Jeija/sigfox-chicken-coop/hardware_pdf/pcb.pdf

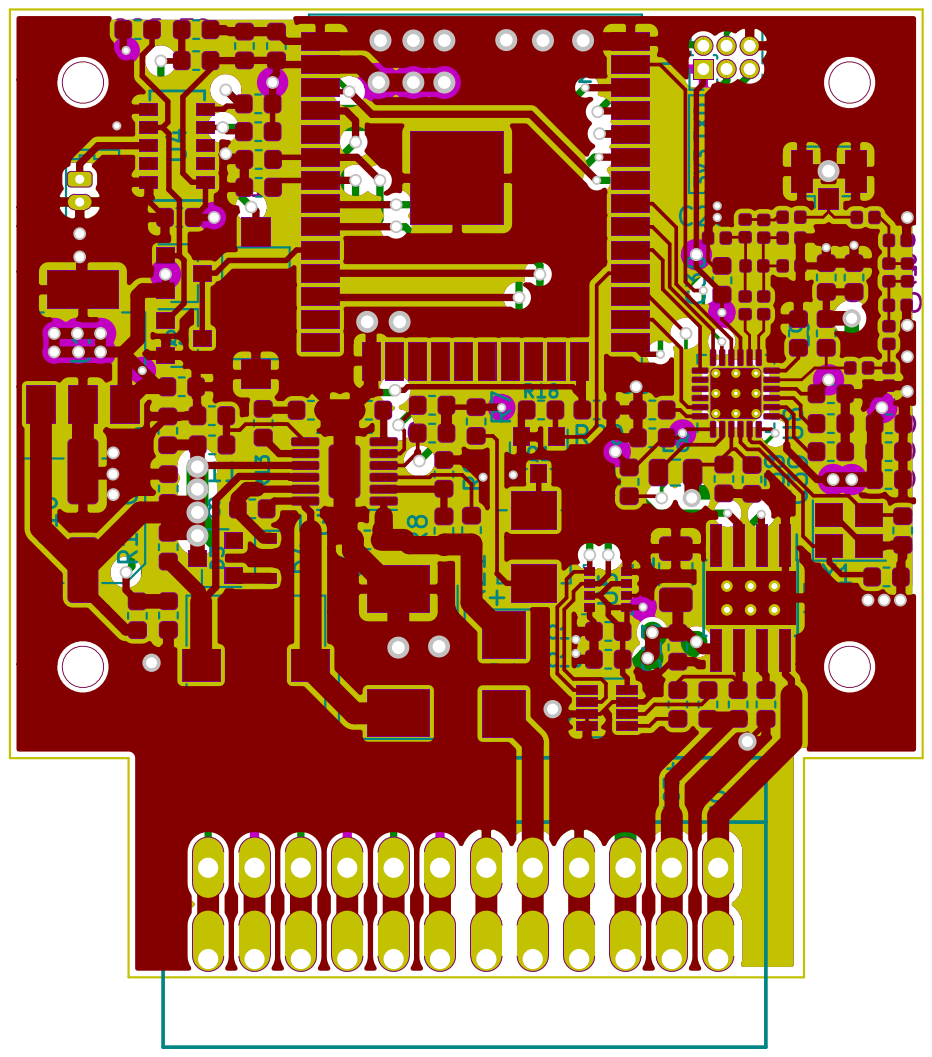
[picture p4: page 1]
