Jeija/sigfox-chicken-coop/hardware/huhnsfx.kicad_pcb

## KiCad design hardware/huhnsfx.kicad_pcb (2020-07-01)

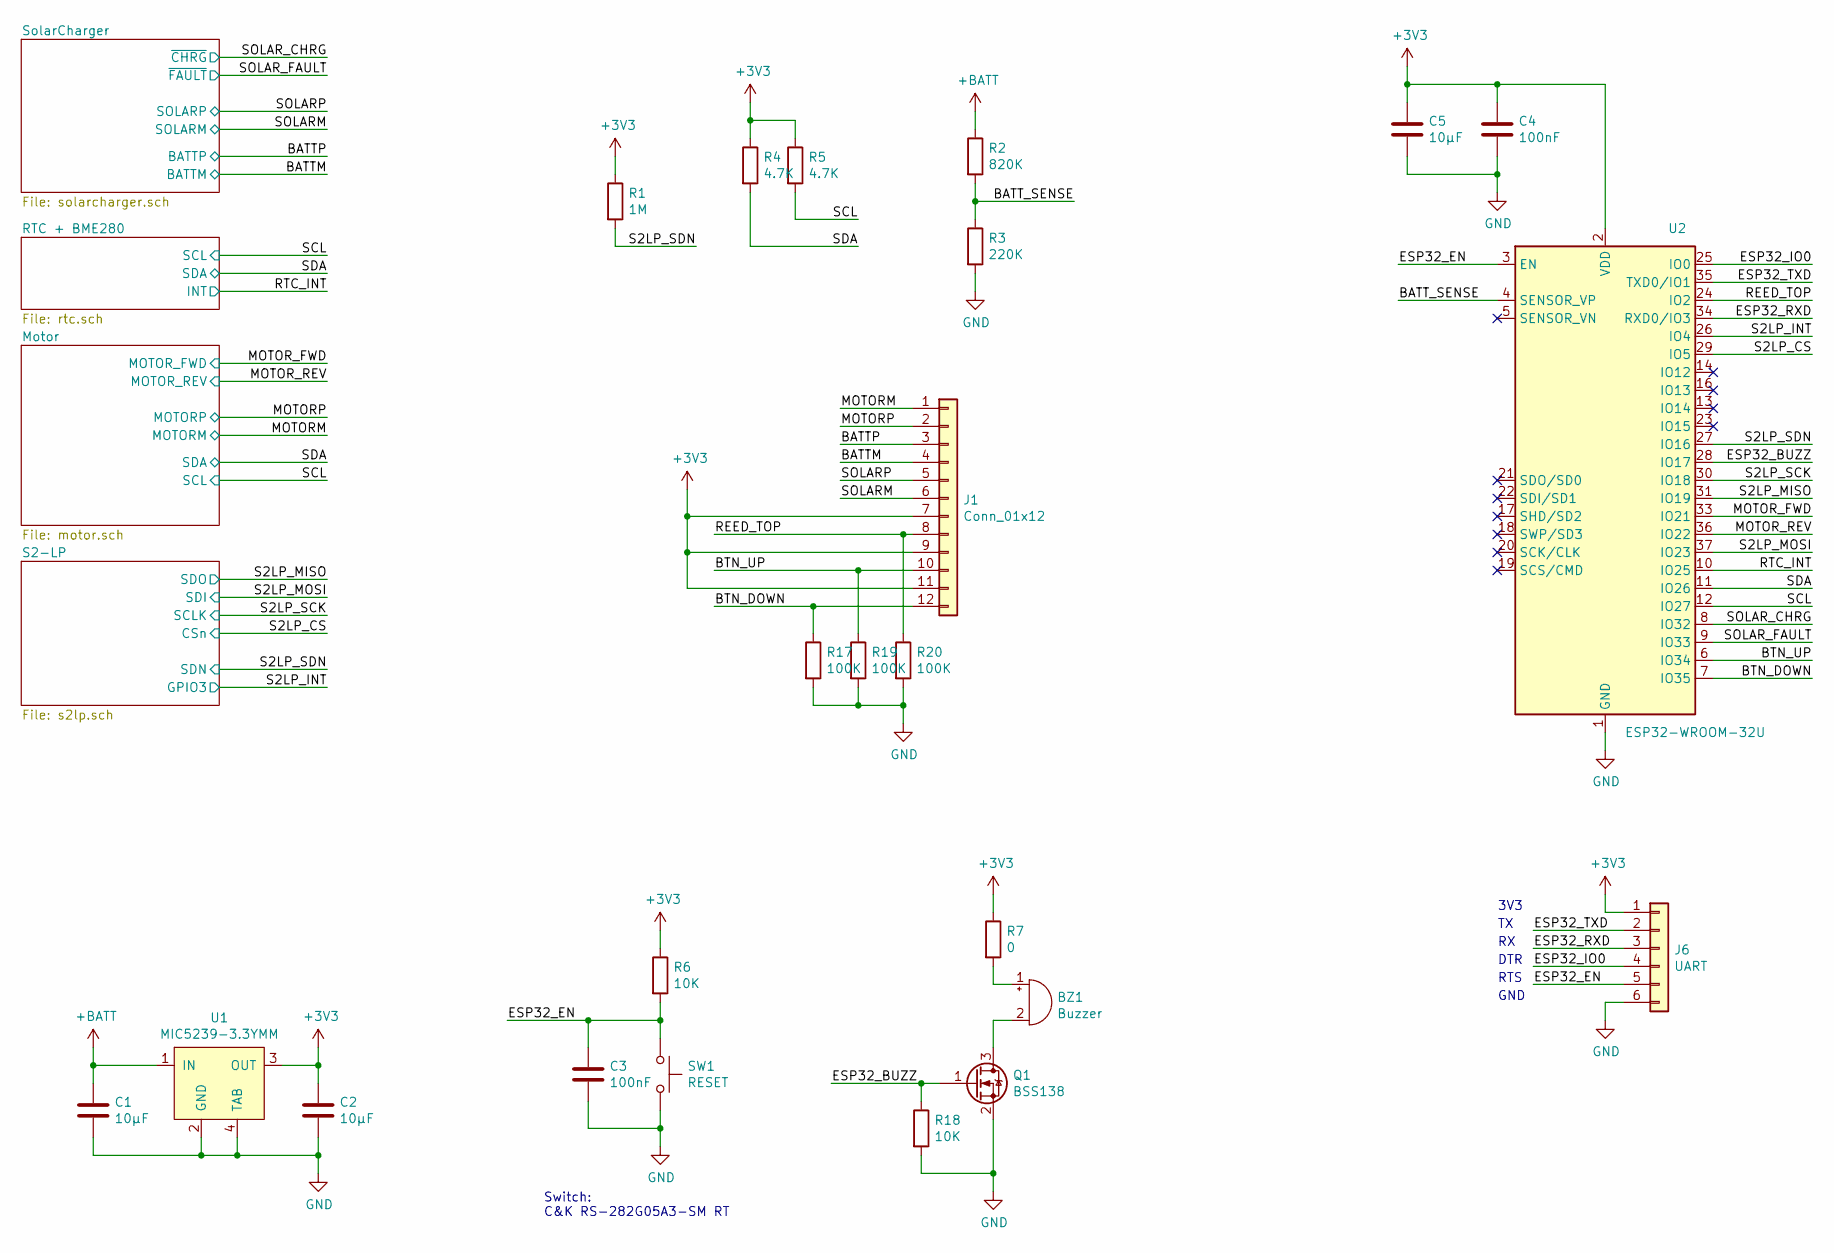
[picture p10: schematic huhnsfx.sch]

Parts:
BZ1: Buzzer; CMT-4023S
C1, C2, C5: 10µF; C_0603_1608Metric
C3, C4: 100nF; C_0603_1608Metric
J1: Conn_01x12; WAGO-233-512
J6: UART; PinHeader_2x03_P1.27mm_Vertical
Q1: BSS138; SOT-23
R1: 1M; R_0603_1608Metric
R2: 820K; R_0603_1608Metric
R3: 220K; R_0603_1608Metric
R4, R5: 4.7K; R_0603_1608Metric
R6, R18: 10K; R_0603_1608Metric
R7: 0; R_0603_1608Metric
R17, R19, R20: 100K; R_0603_1608Metric
SW1: RESET; SW_SPST_CK_RS282G05A3
U1: MIC5239-3.3YMM; SOT-223
U2: ESP32-WROOM-32U

Connections:
+3V3: C2.1, C4.1, C5.1, J1.7, J1.9, J1.11, J6.1, R1.1, R4.1, R5.1, R6.1, R7.1, U1.3 (OUT), U2.2 (VDD); also elsewhere on the board
+BATT: C1.1, J1.3, R2.1, U1.1 (IN); also elsewhere on the board
/BATT_SENSE: R2.2, R3.1, U2.4 (SENSOR_VP)
/BTN_DOWN: J1.12, R17.1, U2.7 (IO35)
/BTN_UP: J1.10, R19.1, U2.6 (IO34)
/ESP32_BUZZ: Q1.1 (G), R18.1, U2.28 (IO17)
/ESP32_EN: C3.1, J6.5, R6.2, SW1.1, U2.3 (EN)
/ESP32_IO0: J6.4, U2.25 (IO0)
/ESP32_RXD: J6.3, U2.34 (RXD0/IO3)
/ESP32_TXD: J6.2, U2.35 (TXD0/IO1)
/MOTORM: J1.1; also elsewhere on the board
/MOTORP: J1.2; also elsewhere on the board
/MOTOR_FWD: U2.33 (IO21); also elsewhere on the board
/MOTOR_REV: U2.36 (IO22); also elsewhere on the board
/REED_TOP: J1.8, R20.1, U2.24 (IO2)
/RTC_INT: U2.10 (IO25); also elsewhere on the board
/S2LP_CS: U2.29 (IO5); also elsewhere on the board
/S2LP_INT: U2.26 (IO4); also elsewhere on the board
/S2LP_MISO: U2.31 (IO19); also elsewhere on the board
/S2LP_MOSI: U2.37 (IO23); also elsewhere on the board
/S2LP_SCK: U2.30 (IO18); also elsewhere on the board
/S2LP_SDN: R1.2, U2.27 (IO16); also elsewhere on the board
/SCL: R5.2, U2.12 (IO27); also elsewhere on the board
/SDA: R4.2, U2.11 (IO26); also elsewhere on the board
/SOLARP: J1.5; also elsewhere on the board
/SOLAR_CHRG: U2.8 (IO32); also elsewhere on the board
/SOLAR_FAULT: U2.9 (IO33); also elsewhere on the board
GND: C1.2, C2.2, C3.2, C4.2, C5.2, J1.4, J1.6, J6.6, Q1.2 (S), R3.2, R17.2, R18.2, R19.2, R20.2, SW1.2, U1.2 (GND), U1.4 (TAB), U2.1 (GND), U2.15 (GND), U2.38 (GND), U2.39 (GND); also elsewhere on the board
unnamed: BZ1.1 (-), R7.2
unnamed: BZ1.2 (+), Q1.3 (D)

Notes on the sheet:
DTR
RTS
GND
3V3
Switch: C&K RS-282G05A3-SM RT

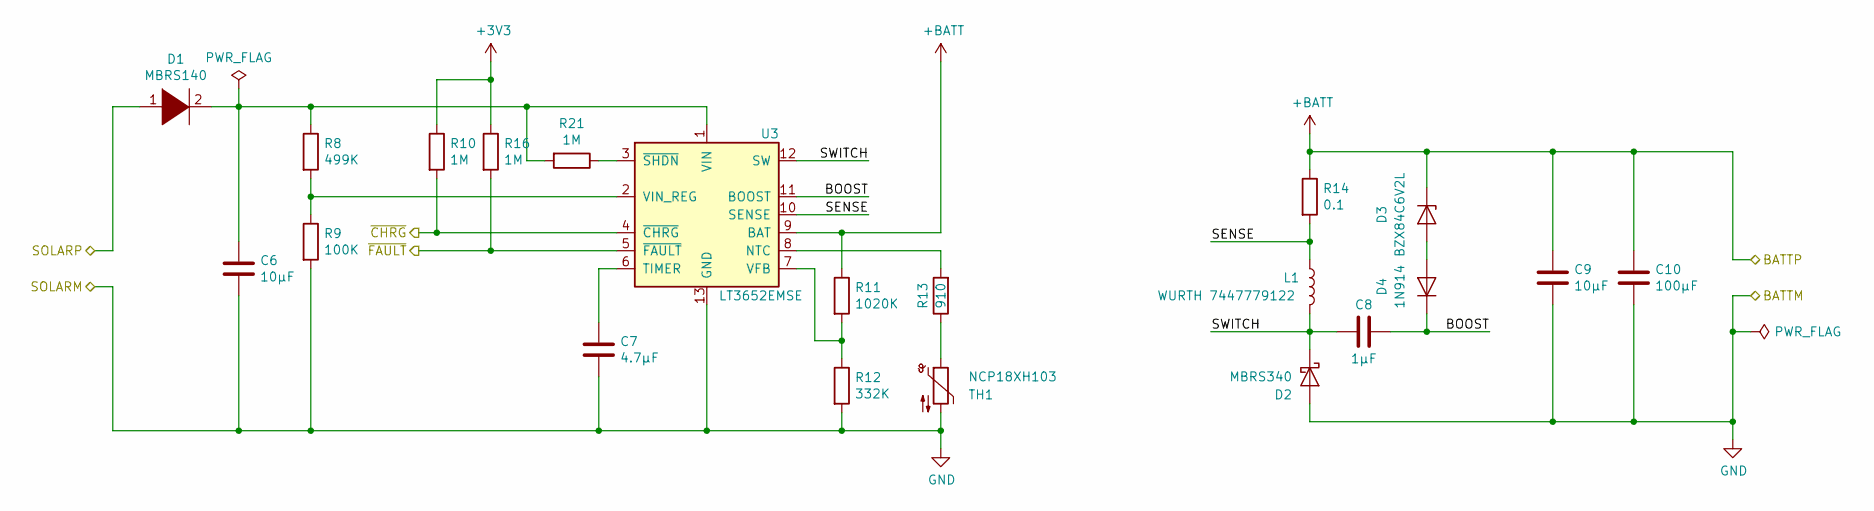
[picture p11: schematic solarcharger.sch]

Parts:
C6, C9: 10µF; C_0603_1608Metric
C7: 4.7µF; C_0603_1608Metric
C8: 1µF; C_0603_1608Metric
C10: 100µF; CP_Elec_6.3x3
D1: MBRS140; D_SMB
D2: MBRS340; D_SMC
D3: BZX84C6V2L; D_SOT-23_ANK
D4: 1N914; D_SOD-323F
L1: WURTH 7447779122; L_Wuerth_WE-PD-Typ-7345
R8: 499K; R_0603_1608Metric
R9: 100K; R_0603_1608Metric
R10, R16, R21: 1M; R_0603_1608Metric
R11: 1020K; R_0603_1608Metric
R12: 332K; R_0603_1608Metric
R13: 910; R_0603_1608Metric
R14: 0.1; R_0603_1608Metric
TH1: NCP18XH103; R_0603_1608Metric
U3: LT3652EMSE; MSOP-12-1EP_3x4mm_P0.65mm_EP1.65x2.85mm

Connections:
+3V3: R10.1, R16.1; also elsewhere on the board
+BATT: C9.1, C10.1, D3.1 (K), R11.1, R14.1, U3.9 (BAT); also elsewhere on the board
/SOLARP: D1.1 (K); also elsewhere on the board
/SOLAR_CHRG: R10.2, U3.4 (~CHRG); also elsewhere on the board
/SOLAR_FAULT: R16.2, U3.5 (~FAULT); also elsewhere on the board
/SolarCharger/BOOST: C8.1, D4.1 (K), U3.11 (BOOST)
/SolarCharger/SENSE: L1.1, R14.2, U3.10 (SENSE)
/SolarCharger/SWITCH: C8.2, D2.1 (K), L1.2, U3.12 (SW)
GND: C6.2, C7.2, C9.2, C10.2, D2.2 (A), R9.2, R12.2, TH1.2, U3.13 (GND); also elsewhere on the board
unnamed: C6.1, D1.2 (A), R8.1, R21.2, U3.1 (VIN)
unnamed: C7.1, U3.6 (TIMER)
unnamed: D3.2 (A), D4.2 (A)
unnamed: R8.2, R9.1, U3.2 (VIN_REG)
unnamed: R11.2, R12.1, U3.7 (VFB)
unnamed: R13.1, TH1.1
unnamed: R13.2, U3.8 (NTC)
unnamed: R21.1, U3.3 (~SHDN)

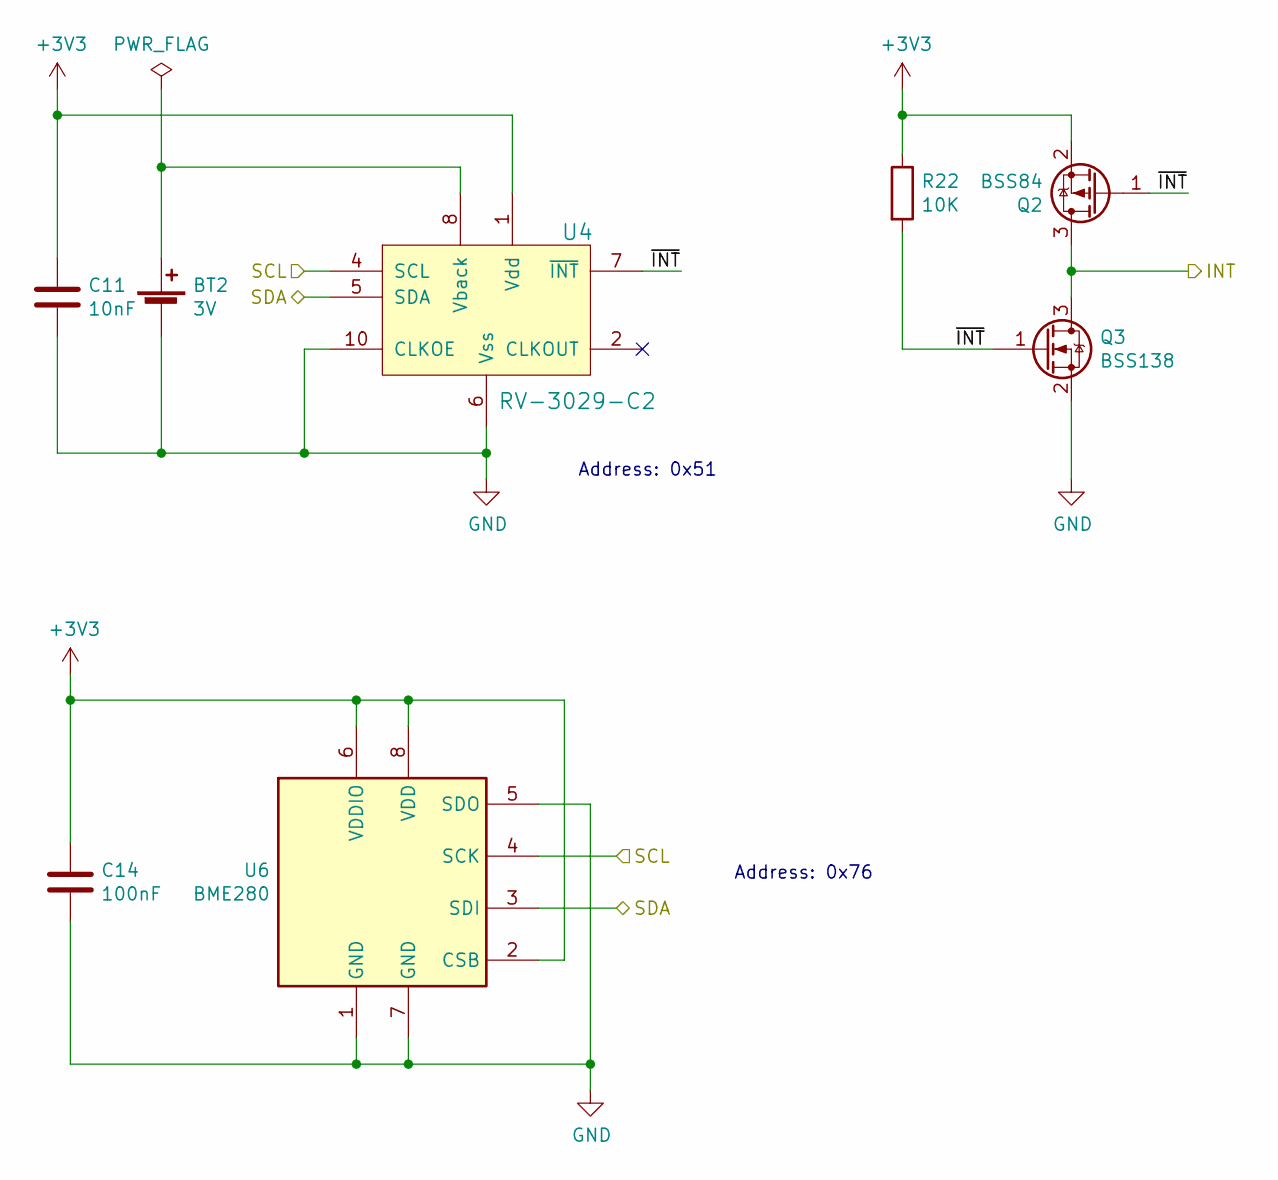
[picture p12: schematic rtc.sch]

Parts:
BT2: 3V; Molex_PicoBlade_53047-0210_1x02_P1.25mm_Vertical
C11: 10nF; C_0603_1608Metric
C14: 100nF; C_0603_1608Metric
Q2: BSS84; SOT-23
Q3: BSS138; SOT-23
R22: 10K; R_0603_1608Metric
U4: RV-3029-C2; rv3029
U6: BME280; Bosch_LGA-8_2.5x2.5mm_P0.65mm_ClockwisePinNumbering

Connections:
+3V3: C11.1, C14.1, Q2.2 (S), R22.1, U4.1 (Vdd), U6.2 (CSB), U6.6 (VDDIO), U6.8 (VDD); also elsewhere on the board
/RTC + BME280/~INT: Q2.1 (G), Q3.1 (G), R22.2, U4.7 (~INT)
/RTC_INT: Q2.3 (D), Q3.3 (D); also elsewhere on the board
/SCL: U4.4 (SCL), U6.4 (SCK); also elsewhere on the board
/SDA: U4.5 (SDA), U6.3 (SDI); also elsewhere on the board
GND: BT2.2 (-), C11.2, C14.2, Q3.2 (S), U4.6 (Vss), U4.10 (CLKOE), U6.1 (GND), U6.5 (SDO), U6.7 (GND); also elsewhere on the board
unnamed: BT2.1 (+), U4.8 (Vback)

Notes on the sheet:
Address: 0x76
Address: 0x51

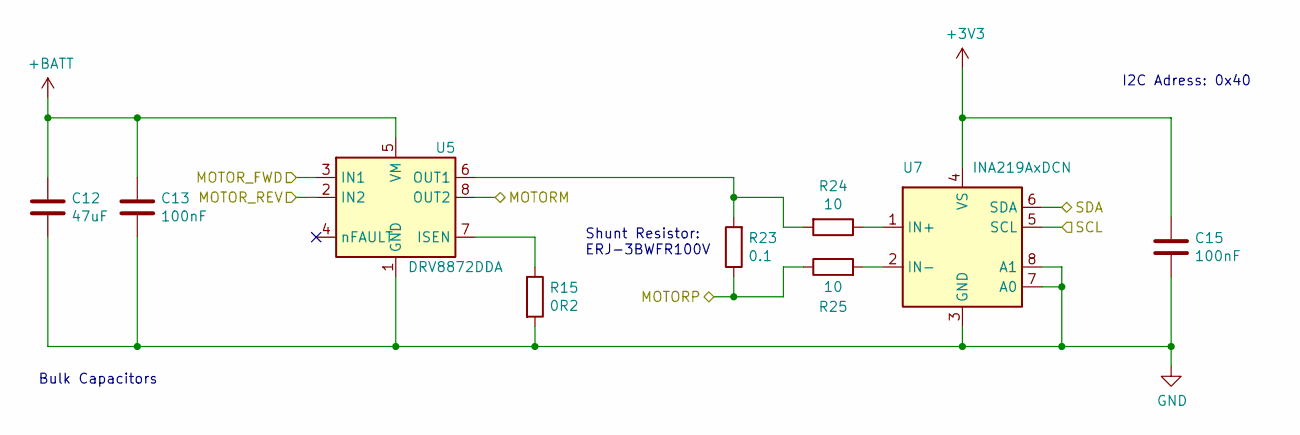
[picture p13: schematic motor.sch]

Parts:
C12: 47uF; C_1206_3216Metric
C13, C15: 100nF; C_0603_1608Metric
R15: 0R2; R_0603_1608Metric
R23: 0.1; R_0603_1608Metric
R24, R25: 10; R_0603_1608Metric
U5: DRV8872DDA; Texas_HTSOP-8-1EP_3.9x4.9mm_P1.27mm_EP2.95x4.9mm_Mask2.4x3.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
U7: INA219AxDCN; SOT-23-8

Connections:
+3V3: C15.1, U7.4 (VS); also elsewhere on the board
+BATT: C12.1, C13.1, U5.5 (VM); also elsewhere on the board
/MOTORM: U5.8 (OUT2); also elsewhere on the board
/MOTORP: R23.1, R25.1; also elsewhere on the board
/MOTOR_FWD: U5.3 (IN1); also elsewhere on the board
/MOTOR_REV: U5.2 (IN2); also elsewhere on the board
/SCL: U7.5 (SCL); also elsewhere on the board
/SDA: U7.6 (SDA); also elsewhere on the board
GND: C12.2, C13.2, C15.2, R15.2, U5.1 (GND), U5.9 (GND), U7.3 (GND), U7.7 (A0), U7.8 (A1); also elsewhere on the board
unnamed: R15.1, U5.7 (ISEN)
unnamed: R23.2, R24.2, U5.6 (OUT1)
unnamed: R24.1, U7.1 (IN+)
unnamed: R25.2, U7.2 (IN-)

Notes on the sheet:
Bulk Capacitors
I2C Adress: 0x40
Shunt Resistor: ERJ-3BWFR100V

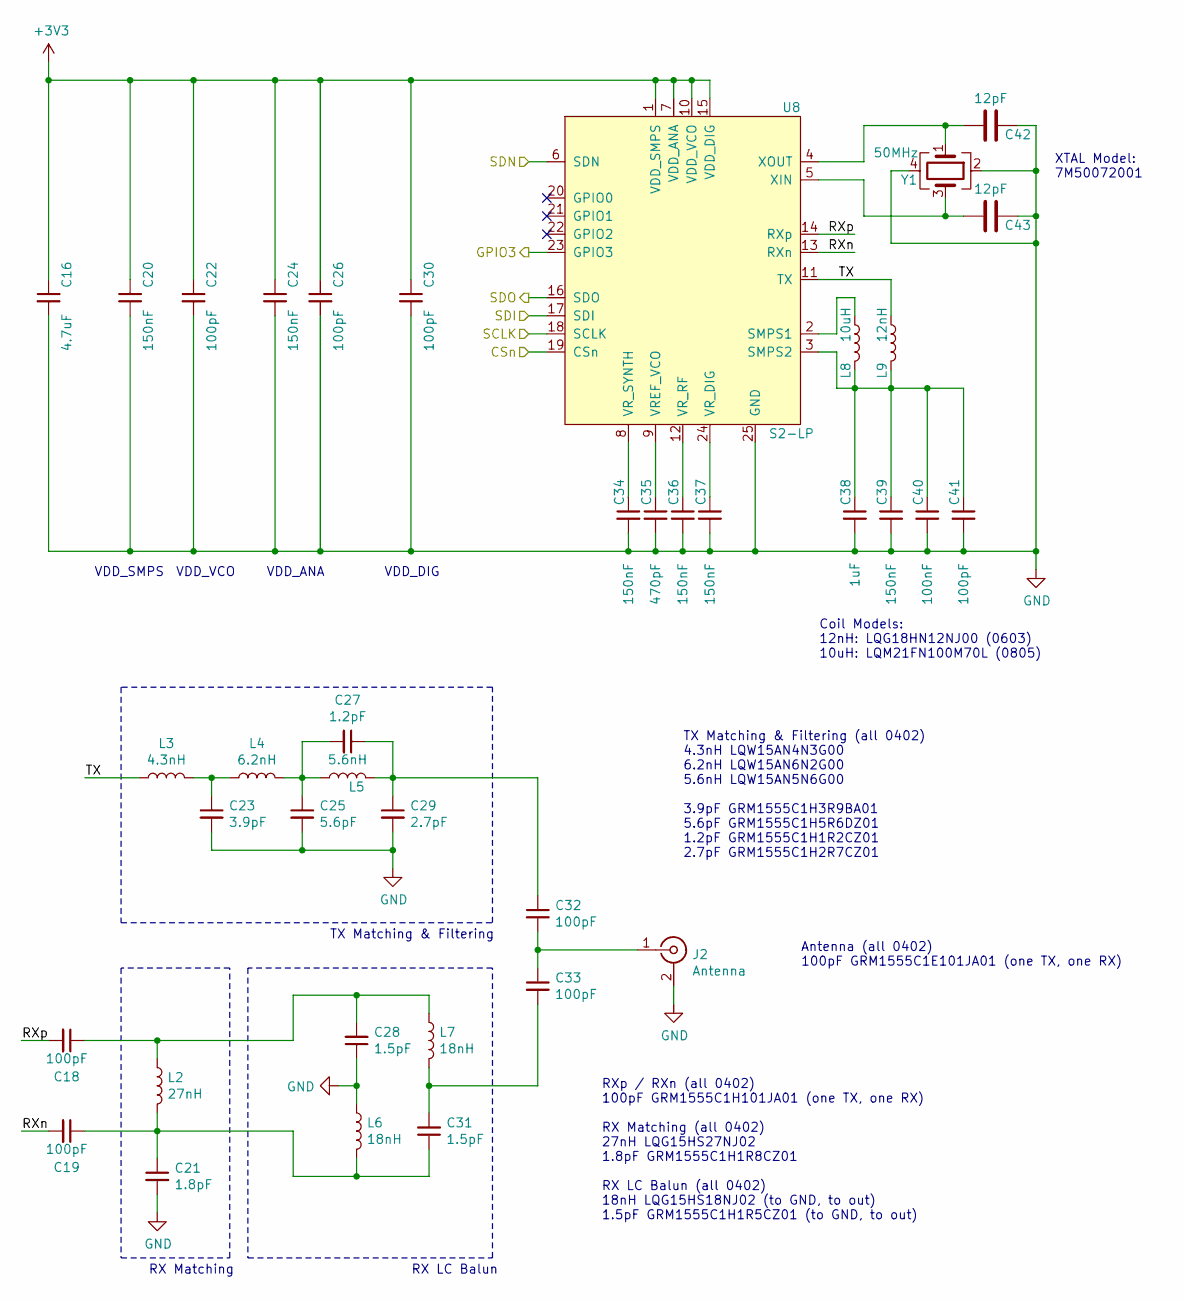
[picture p14: schematic s2lp.sch]

Parts:
C16: 4.7uF; C_0603_1608Metric
C18, C19, C32, C33: 100pF; C_0402_1005Metric
C20, C24, C34, C36, C37, C39: 150nF; C_0603_1608Metric
C21: 1.8pF; C_0402_1005Metric
C22, C26, C30, C41: 100pF; C_0603_1608Metric
C23: 3.9pF; C_0402_1005Metric
C25: 5.6pF; C_0402_1005Metric
C27: 1.2pF; C_0402_1005Metric
C28, C31: 1.5pF; C_0402_1005Metric
C29: 2.7pF; C_0402_1005Metric
C35: 470pF; C_0603_1608Metric
C38: 1uF; C_0603_1608Metric
C40: 100nF; C_0603_1608Metric
C42, C43: 12pF; C_0603_1608Metric
J2: Antenna; U.FL_Hirose_U.FL-R-SMT-1_Vertical
L2: 27nH; L_0402_1005Metric
L3: 4.3nH; L_0402_1005Metric
L4: 6.2nH; L_0402_1005Metric
L5: 5.6nH; L_0402_1005Metric
L6, L7: 18nH; L_0402_1005Metric
L8: 10uH; L_0805_2012Metric
L9: 12nH; L_0603_1608Metric
U8: S2-LP; QFN-24-1EP_4x4mm_P0.5mm_EP2.7x2.7mm_ThermalVias
Y1: 50MHz; Crystal_SMD_3225-4Pin_3.2x2.5mm

Connections:
+3V3: C16.1, C20.1, C22.1, C24.1, C26.1, C30.1, U8.1 (VDD_SMPS), U8.7 (VDD_ANA), U8.10 (VDD_VCO), U8.15 (VDD_DIG); also elsewhere on the board
/S2-LP/RXn: C19.2, U8.13 (RXn)
/S2-LP/RXp: C18.2, U8.14 (RXp)
/S2-LP/TX: L3.1, L9.1, U8.11 (TX)
/S2LP_CS: U8.19 (CSn); also elsewhere on the board
/S2LP_INT: U8.23 (GPIO3); also elsewhere on the board
/S2LP_MISO: U8.16 (SDO); also elsewhere on the board
/S2LP_MOSI: U8.17 (SDI); also elsewhere on the board
/S2LP_SCK: U8.18 (SCLK); also elsewhere on the board
/S2LP_SDN: U8.6 (SDN); also elsewhere on the board
GND: C16.2, C20.2, C21.2, C22.2, C23.2, C24.2, C25.2, C26.2, C28.1, C29.2, C30.2, C34.2, C35.2, C36.2, C37.2, C38.2, C39.2, C40.2, C41.2, C42.1, C43.1, J2.2 (Ext), L6.1, U8.25 (GND), Y1.2, Y1.4; also elsewhere on the board
unnamed: C18.1, C28.2, L2.1, L7.1
unnamed: C19.1, C21.1, C31.1, L2.2, L6.2
unnamed: C23.1, L3.2, L4.1
unnamed: C25.1, C27.2, L4.2, L5.1
unnamed: C27.1, C29.1, C32.1, L5.2
unnamed: C31.2, C33.2, L7.2
unnamed: C32.2, C33.1, J2.1 (In)
unnamed: C34.1, U8.8 (VR_SYNTH)
unnamed: C35.1, U8.9 (VREF_VCO)
unnamed: C36.1, U8.12 (VR_RF)
unnamed: C37.1, U8.24 (VR_DIG)
unnamed: C38.1, C39.1, C40.1, C41.1, L8.2, L9.2, U8.3 (SMPS2)
unnamed: C42.2, U8.4 (XOUT), Y1.1
unnamed: C43.2, U8.5 (XIN), Y1.3
unnamed: L8.1, U8.2 (SMPS1)

Notes on the sheet:
VDD_SMPS
VDD_VCO
VDD_ANA
VDD_DIG
Coil Models: 12nH: LQG18HN12NJ00 (0603) 10uH: LQM21FN100M70L (0805)
RX LC Balun
RX Matching
TX Matching & Filtering
XTAL Model: 7M50072001
TX Matching & Filtering (all 0402) 4.3nH LQW15AN4N3G00 6.2nH LQW15AN6N2G00 5.6nH LQW15AN5N6G00 3.9pF GRM1555C1H3R9BA01 5.6pF GRM1555C1H5R6DZ01 1.2pF GRM1555C1H1R2CZ01 2.7pF GRM1555C1H2R7CZ01
Antenna (all 0402) 100pF GRM1555C1E101JA01 (one TX, one RX)
RXp / RXn (all 0402) 100pF GRM1555C1H101JA01 (one TX, one RX) RX Matching (all 0402) 27nH LQG15HS27NJ02 1.8pF GRM1555C1H1R8CZ01 RX LC Balun (all 0402) 18nH LQG15HS18NJ02 (to GND, to out) 1.5pF GRM1555C1H1R5CZ01 (to GND, to out)

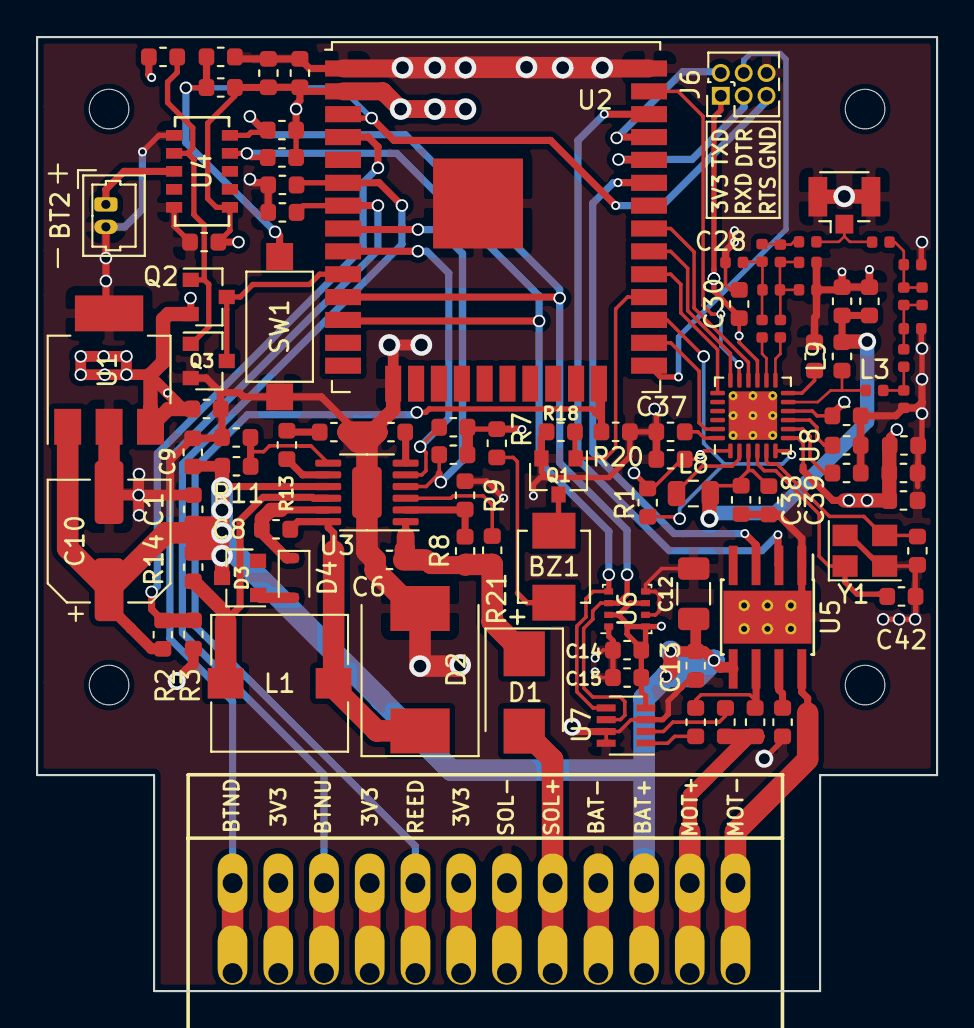
[picture p15: board huhnsfx.kicad_pcb from above]

Board: 4 copper layers, 50.0 x 53.0 mm, 99 parts (0 on the bottom side), 65 nets.
