Jeija/sigfox-chicken-coop/firmware/main/src/motor.c

#include <driver/gpio.h>

#include "motor.h"

static motor_state_t current_motor_state = MOTOR_OFF;

esp_err_t motor_init(void)
{
	esp_err_t res = ESP_OK;

	res |= gpio_reset_pin(CONFIG_GPIO_MOTOR_UP);
	res |= gpio_set_direction(CONFIG_GPIO_MOTOR_UP, GPIO_MODE_OUTPUT);

	res |= gpio_reset_pin(CONFIG_GPIO_MOTOR_DOWN);
	res |= gpio_set_direction(CONFIG_GPIO_MOTOR_DOWN, GPIO_MODE_OUTPUT);

	return res;
}

esp_err_t motor_set(motor_state_t state)
{
	esp_err_t res = ESP_OK;

	res |= gpio_set_level(CONFIG_GPIO_MOTOR_UP, (state == MOTOR_UP || state == MOTOR_UP_UNTIL_LATCH || state == MOTOR_BRAKE) ? 1 : 0);
	res |= gpio_set_level(CONFIG_GPIO_MOTOR_DOWN, (state == MOTOR_DOWN || state == MOTOR_DOWN_UNTIL_LATCH || state == MOTOR_BRAKE) ? 1 : 0);
	if (res == ESP_OK)
		current_motor_state = state;

	return res;
}

motor_state_t motor_get_state(void)
{
	return current_motor_state;
}

const char *motor_state_to_string(motor_state_t state)
{
	switch (state) {
		case MOTOR_UP:
			return "UP";
		case MOTOR_DOWN:
			return "DOWN";
		case MOTOR_BRAKE:
			return "BRAKE";
		case MOTOR_UP_UNTIL_LATCH:
			return "UP_UNTIL_LATCH";
		case MOTOR_DOWN_UNTIL_LATCH:
			return "DOWN_UNTIL_LATCH";
		case MOTOR_OFF:
		default:
			return "OFF";
	}
}
