Jeija/sigfox-chicken-coop/firmware/main/src/i2cdevice.h

#ifndef _I2CDEVICE_H
#define _I2CDEVICE_H

#include <stdint.h>

#include "esp_err.h"

esp_err_t i2cdevice_init(void);

esp_err_t i2cdevice_write(uint8_t dev_addr, uint8_t reg_addr, uint8_t *reg_data, uint16_t len);
esp_err_t i2cdevice_write_byte(uint8_t dev_addr, uint8_t reg_add, uint8_t data);
esp_err_t i2cdevice_write_bit(uint8_t dev_addr, uint8_t reg_add, uint8_t bit, uint8_t val);

esp_err_t i2cdevice_read(uint8_t dev_addr, uint8_t reg_addr, uint8_t *reg_data, uint16_t len);
esp_err_t i2cdevice_read_byte(uint8_t dev_addr, uint8_t reg_add, uint8_t *data);

#endif
