Jeija/sigfox-chicken-coop/(commit log)

2020-07-01 Initial upload with hardware design (no software yet)
    [huhnsfx.kicad_pcb, huhnsfx.sch, motor.sch, rtc.sch, s2lp.sch, solarcharger.sch]
2020-07-01 Add submodules for firmware (renard-phy-s2lp, renard-phy-s2lp-hal-esp32)
2020-07-29 Abort Sigfox TX / RX upon button interrupt / RTC interrupt
    Uses new platform-specific renard-phy-s2lp-hal-esp32 feature
2020-10-19 Remove stall detection once and for all, update renard libraries
    [main.c, sigfox.c]
2020-10-19 Switch back to 100bps uplink baudrate
2026-04-05 Improve button handling
2026-04-05 Abort transmission if button is pressed
2026-04-05 Update hardware folder (opened with newer KiCad)
2026-04-05 Update renard-phy-s2lp-hal-esp32
